Svishwa2004/Optical_Ph-sensor/(list of files, drawings)

Other design files:
Instructions/Autorouter_PCB_PCB_Ph-sensor_2026-06-11.dsn
