Svishwa2004/Optical_Ph-sensor/(commit log)

2026-05-29 feat: update base fill duration and add dynamic configuration
    - Changed BASE_FILL_MS to a dynamic variable baseFillMs with default value.
    - Introduced clampSeconds function to ensure valid range for base fill seconds.
    - Added setBaseFillSeconds function to update base fill duration based on user input.
    - Updated getStateDuration to use baseFillMs instead of a constant.
    - Modified API to accept baseFillSec parameter for dynamic configuration.
    - Enhanced status JSON to include current base fill duration in milliseconds and seconds.
2026-06-13 feat: initialize optical pH sensor project with dashboard UI, PCB documentation, and firmware structure
    [Autorouter_PCB_PCB_Ph-sensor_2026-06-11.dsn]
2026-07-03 Enhance pump control and sensor handling
    - Introduced kick-start duty cycle for Pump 2 to overcome static friction.
    - Added retry mechanism for zero readings from the TCS34725 sensor.
    - Improved calibration value validation and error handling.
    - Updated state duration calculations to ensure progress bar accuracy.
    - Enhanced status reporting with timestamps for better debugging.
    - Refined OLED display updates for clearer information presentation.
    - Integrated hardware watchdog timer to prevent system hangs.
    [BOM_PCB_Ph-sensor_2026-06-11.csv]
2026-07-03 feat: update PWM frequencies and duty cycles for improved pump performance
2026-07-05 feat: implement pH sensor control firmware with LiquidCrystal I2C support and PWM pump management
2026-07-05 feat: implement custom pH sensor control firmware with FSM, PWM pump management, and WebSocket configuration
2026-07-13 Custome base fill (#2)
    * feat: implement pH sensor control firmware with LiquidCrystal I2C support and PWM pump management
    * feat: implement custom pH sensor control firmware with FSM, PWM pump management, and WebSocket configuration
    * chore: generate clangd compile commands for project indexing
    ---------
2026-08-06 fix: update DRAIN_MS duration from 3000 to 6000 for improved operation
    [main.cpp]
2026-08-07 fix: update default base fill duration to 24000 ms for improved accuracy
    [main.cpp]
2026-08-08 Add host-side regression tests for pH sensor firmware
    - Introduced `run_host_tests.sh` script to compile and run unit tests without hardware dependencies.
    - Added `test_fluidics.cpp` to verify fluidic geometry and timing constants extracted from `src/main.cpp`.
    - Implemented `test_colormath.cpp` to validate color-math and calibration logic, mirroring relevant functions from `main.cpp`.
    - Updated `README` to document the new host tests and their execution instructions.
